jmsweng/11-ID-D-Sample-stage/README.md

# 11-ID-D-Sample-stage
Sample stage for beamline 11-ID-D
