jmsweng/11-ID-D-Sample-stage/Step files/Z bottom plate, A.step

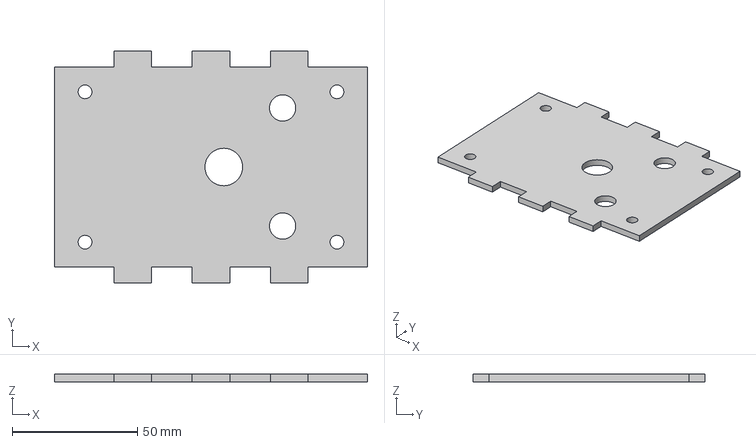
[picture p1: CAD file, 2024-04-30]
Step files/Z bottom plate, A.step
125.0 x 92.7 x 3.17 mm
