jmsweng/11-ID-D-Sample-stage/Step files/Z bottom plate, B.step

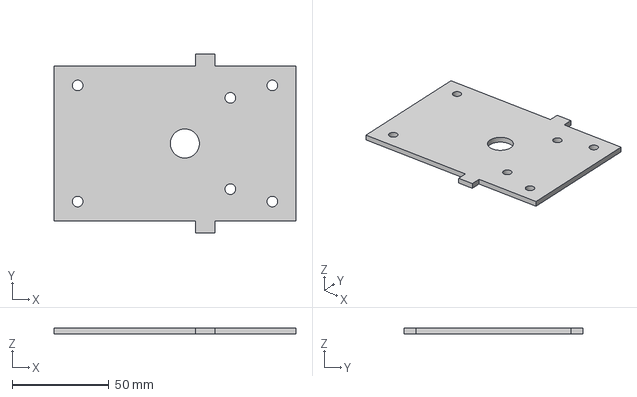
[picture p2: CAD file, 2024-04-30]
Step files/Z bottom plate, B.step
125.0 x 92.7 x 3.18 mm
