jmsweng/11-ID-D-Sample-stage/Step files/Z side plates.step

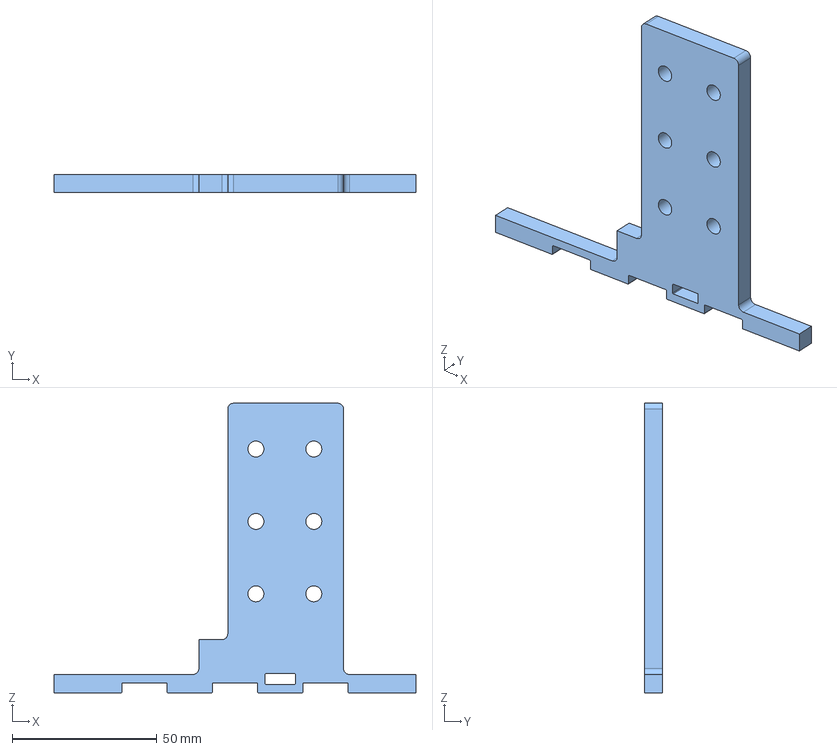
[picture p3: CAD file, 2024-04-30]
Step files/Z side plates.step
125.0 x 6.35 x 100.0 mm
