jmsweng/11-ID-D-Sample-stage/Step files/BKL-4 adapter plate, no countersink.step

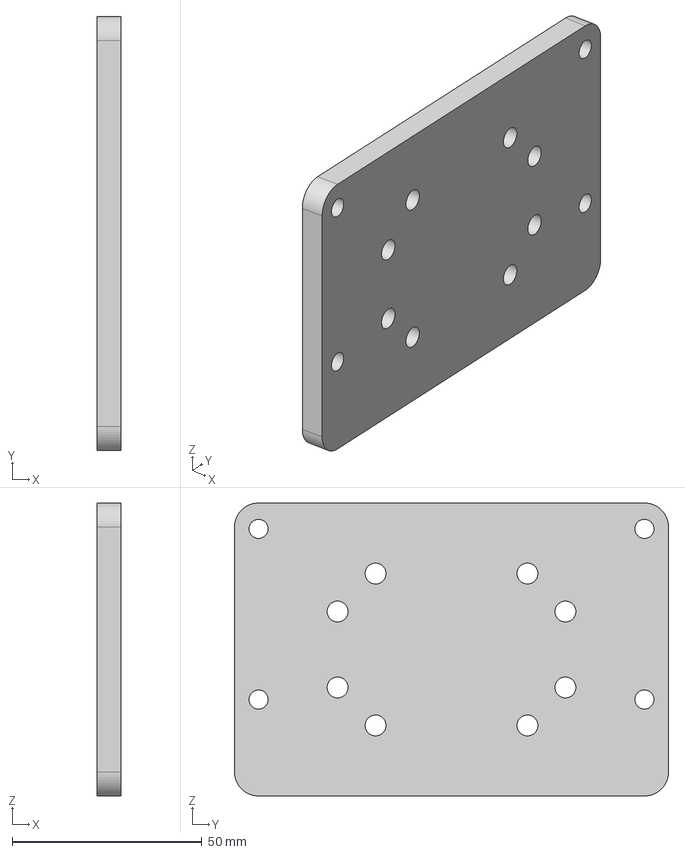
[picture p4: CAD file, 2024-04-30]
Step files/BKL-4 adapter plate, no countersink.step
6.35 x 114.3 x 77.2 mm
