jmsweng/11-ID-D-Sample-stage/Step files/Build instructions.docx

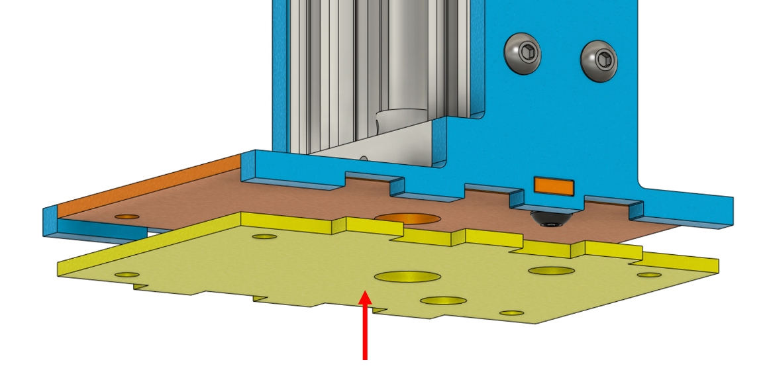
[picture p19: figure]
