jmsweng/11-ID-D-Sample-stage/Step files/readme

Step files for sample stage parts. 
Parts should are 1/4" thick.
Adapter plate to connect BKL-4 kinematic mount to Z axis has a file without countersinking for production by laser cutting.
